madvoid/LEMS_PCB/README.txt

Eagle Files for LEMS PCB
Work in progress

The Mega Shield Schematic/Layout will be used as a reference in the future
