madvoid/LEMS_PCB/Shield.brd

## EAGLE design Shield.brd (2012-08-28)

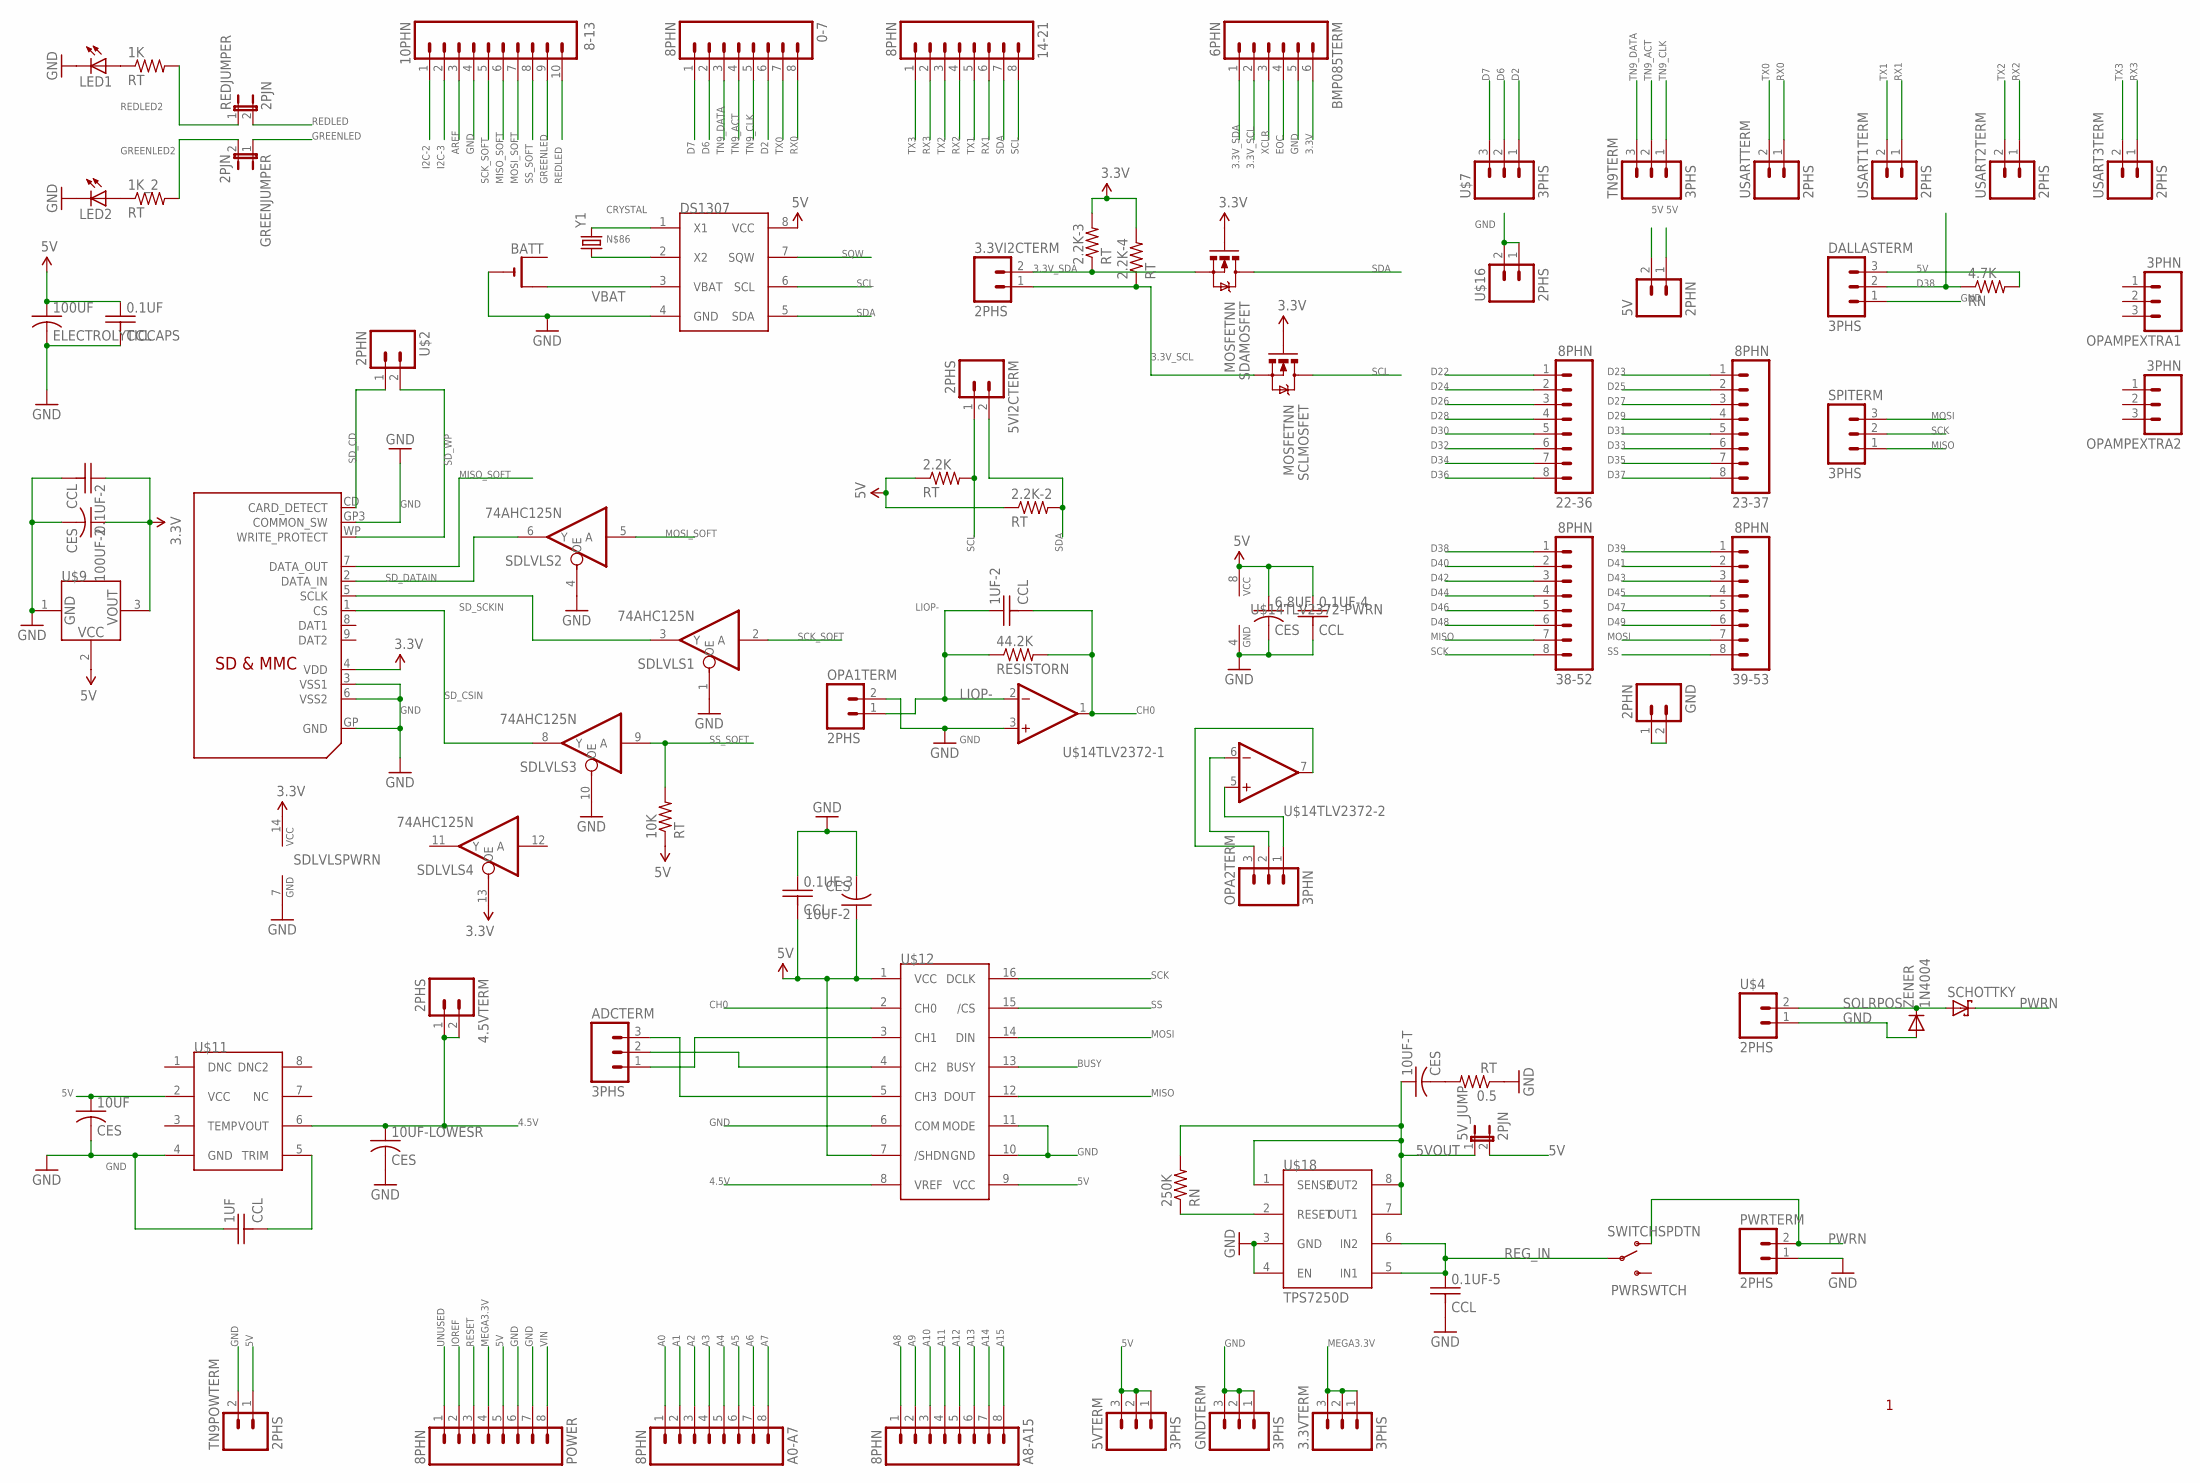
[picture p1: schematic Shield.sch]

Parts:
0-7, 14-21, 22-36, 23-37, 38-52, 39-53: 8PHN; 8PH
0.1UF, 0.1UF-2, 0.1UF-3, 0.1UF-4, 0.1UF-5, 1UF, 1UF-2: CCL; C025-025X050
0.5, 1K, 1K_2, 2.2K, 2.2K-2, 2.2K-3, 2.2K-4, 10K: RT; 0207/7
3.3VI2CTERM, 4.5VTERM, 5VI2CTERM: 2PHS; SCREWTERMINAL-3.5MM-2_LOCK
3.3VTERM, 5VTERM: 3PHS; SCREWTERMINAL-3.5MM-3_LOCK.007S
4.7K, 250K: RN; 0207/10
5V: 2PHN; 2PH
5V_JUMP: 2PJN; 2PH
6.8UF, 10UF, 10UF-2, 10UF-LOWESR, 10UF-T, 100UF-2: CES; E2,5-5
8-13: 10PHN; 10PH
44.2K: RESISTORN; 0207/10
100UF: ELECTROLYTICCAPS; E2,5-5
A0-A7, A8-A15: 8PHN; 8PH
ADCTERM: 3PHS; SCREWTERMINAL-3.5MM-3_LOCK.007S
BATT: CR1220THM; CR1220-THM
BMP085TERM: 6PHN; 6PH
DALLASTERM: 3PHS; SCREWTERMINAL-3.5MM-3_LOCK.007S
DS1307: DS1307P; DIL8
GND: 2PHN; 2PH
GNDTERM: 3PHS; SCREWTERMINAL-3.5MM-3_LOCK.007S
GREENJUMPER: 2PJN; 2PH
LED1, LED2: LED3MM
OPA1TERM: 2PHS; SCREWTERMINAL-3.5MM-2_LOCK
OPA2TERM: 3PHN; 3PH
OPAMPEXTRA1, OPAMPEXTRA2: 3PHN; 3PH
POWER: 8PHN; 8PH
PWRSWTCH: SWITCHSPDTN; SWITCH-SPDT
PWRTERM: 2PHS; SCREWTERMINAL-3.5MM-2_LOCK
REDJUMPER: 2PJN; 2PH
SCHOTTKY: SCHOTTKY-DIODEDO41; DO41-10
SCLMOSFET: MOSFETNN; TO-92INLINE
SDAMOSFET: MOSFETNN; TO-92INLINE
SDLVLS: 74AHC125N; DIL14
SPITERM: 3PHS; SCREWTERMINAL-3.5MM-3_LOCK.007S
TN9POWTERM: 2PHS; SCREWTERMINAL-3.5MM-2_LOCK
TN9TERM: 3PHS; SCREWTERMINAL-3.5MM-3_LOCK.007S
U$1: SDMMC06132; 06132
U$2: 2PHN; 2PH
U$4, U$16: 2PHS; SCREWTERMINAL-3.5MM-2_LOCK
U$7: 3PHS; SCREWTERMINAL-3.5MM-3_LOCK.007S
U$9: MCP1700-330T; TO-92INLINE
U$11: REF5045S; SOIC8
U$12: ADS7841P; DIL16
U$14: TLV2372P; DIL8
U$18: TPS7250D; DIL8
USART1TERM, USART2TERM, USART3TERM: 2PHS; SCREWTERMINAL-3.5MM-2_LOCK
USARTTERM: 2PHS; SCREWTERMINAL-3.5MM-2_LOCK
Y1: CRYSTALTC38H; TC38H
ZENER: 1N4004; DO41-10

Connections:
3.3V: 0.1UF-2.1, 2.2K-3.2, 2.2K-4.2, 100UF-2.+ (1), BMP085TERM.6, SCLMOSFET.2 (G), SDAMOSFET.2 (G), SDLVLS.13 (OE), SDLVLS.14 (VCC), U$1.4 (VDD), U$9.3 (VOUT)
3.3V_SCL: 2.2K-4.1, 3.3VI2CTERM.1, BMP085TERM.2, SCLMOSFET.1 (S)
3.3V_SDA: 2.2K-3.1, 3.3VI2CTERM.2, BMP085TERM.1, SDAMOSFET.1 (S)
4.5V: 4.5VTERM.1, 4.5VTERM.2, 10UF-LOWESR.+ (1), U$11.6 (VOUT), U$12.8 (VREF)
5V: 0.1UF.1, 0.1UF-3.2, 0.1UF-4.1, 2.2K.1, 2.2K-2.1, 4.7K.2, 5V.1, 5V.2, 5VTERM.1, 5VTERM.2, 5VTERM.3, 5V_JUMP.2, 6.8UF.+ (1), 10K.1, 10UF.+ (1), 10UF-2.+ (1), 100UF.+ (1), DALLASTERM.3, DS1307.8 (VCC), POWER.5, TN9POWTERM.1, U$9.2 (VCC), U$11.2 (VCC), U$12.1 (VCC), U$12.7 (/SHDN), U$12.9 (VCC), U$14.8 (VCC)
5VOUT: 5V_JUMP.1, 10UF-T.+ (1), 250K.2, U$18.1 (SENSE), U$18.7 (OUT1), U$18.8 (OUT2)
A0: A0-A7.1
A1: A0-A7.2
A2: A0-A7.3
A3: A0-A7.4
A4: A0-A7.5
A5: A0-A7.6
A6: A0-A7.7
A7: A0-A7.8
A8: A8-A15.1
A9: A8-A15.2
A10: A8-A15.3
A11: A8-A15.4
A12: A8-A15.5
A13: A8-A15.6
A14: A8-A15.7
A15: A8-A15.8
AREF: 8-13.3
BUSY: U$12.13 (BUSY)
CH0: 1UF-2.2, 44.2K.2, U$12.2 (CH0), U$14.1 (OUT)
CH1: ADCTERM.1, U$12.3 (CH1)
CH2: ADCTERM.2, U$12.4 (CH2)
CH3: ADCTERM.3, U$12.5 (CH3)
CRYSTAL: DS1307.1 (X1), Y1.2
D2: 0-7.6, U$7.1
D6: 0-7.2, U$7.2
D7: 0-7.1, U$7.3
D22: 22-36.1
D23: 23-37.1
D24: 22-36.2
D25: 23-37.2
D26: 22-36.3
D27: 23-37.3
D28: 22-36.4
D29: 23-37.4
D30: 22-36.5
D31: 23-37.5
D32: 22-36.6
D33: 23-37.6
D34: 22-36.7
D35: 23-37.7
D36: 22-36.8
D37: 23-37.8
D38: 4.7K.1, 38-52.1, DALLASTERM.2
D39: 39-53.1
D40: 38-52.2
D41: 39-53.2
D42: 38-52.3
D43: 39-53.3
D44: 38-52.4
D45: 39-53.4
D46: 38-52.5
D47: 39-53.5
D48: 38-52.6
D49: 39-53.6
EOC: BMP085TERM.4
GND: 0.1UF.2, 0.1UF-2.2, 0.1UF-3.1, 0.1UF-4.2, 0.1UF-5.2, 0.5.1, 1UF.1, 6.8UF.- (2), 8-13.4, 10UF.- (2), 10UF-2.- (2), 10UF-LOWESR.- (2), 100UF.- (2), 100UF-2.- (2), BATT.-, BMP085TERM.5, DALLASTERM.1, DS1307.4 (GND), GNDTERM.1, GNDTERM.2, GNDTERM.3, LED1.K (C), LED2.K (C), OPA1TERM.2, POWER.6, POWER.7, PWRTERM.1, SDLVLS.1 (OE), SDLVLS.4 (OE), SDLVLS.7 (GND), SDLVLS.10 (OE), TN9POWTERM.2, U$1.3 (VSS1), U$1.6 (VSS2), U$1.GP (GND), U$1.GP3 (COMMON_SW), U$4.1, U$9.1 (GND), U$11.4 (GND), U$12.6 (COM), U$12.10 (GND), U$12.11 (MODE), U$14.3 (+IN), U$14.4 (GND), U$16.1, U$16.2, U$18.3 (GND), U$18.4 (EN), ZENER.A
GREENLED: 8-13.9, GREENJUMPER.1
GREENLED2: 1K_2.2, GREENJUMPER.2
I2C-2: 8-13.1
I2C-3: 8-13.2
IOREF: POWER.2
LIOP-: 1UF-2.1, 44.2K.1, OPA1TERM.1, U$14.2 (-IN)
MEGA3.3V: 3.3VTERM.1, 3.3VTERM.2, 3.3VTERM.3, POWER.4
MISO: 38-52.7, SPITERM.1, U$12.12 (DOUT)
MISO_SOFT: 8-13.6, U$1.7 (DATA_OUT)
MOSI: 39-53.7, SPITERM.3, U$12.14 (DIN)
MOSI_SOFT: 8-13.7, SDLVLS.5 (A)
unnamed: 1UF.2, U$11.5 (TRIM)
unnamed: OPA2TERM.1, U$14.5 (+IN)
unnamed: OPA2TERM.2, U$14.6 (-IN)
unnamed: OPA2TERM.3, U$14.7 (OUT)
unnamed: GND.1, GND.2
unnamed: 250K.1, U$18.2 (RESET)
unnamed: 0.5.2, 10UF-T.- (2)
unnamed: 1K.1, LED1.A
unnamed: 1K_2.1, LED2.A
unnamed: DS1307.2 (X2), Y1.1
PWRN: PWRSWTCH.1 (O), PWRTERM.2, SCHOTTKY.C
REDLED: 8-13.10, REDJUMPER.2
REDLED2: 1K.2, REDJUMPER.1
REG_IN: 0.1UF-5.1, PWRSWTCH.2, U$18.5 (IN1), U$18.6 (IN2)
RESET: POWER.3
RX0: 0-7.8, USARTTERM.1
RX1: 14-21.6, USART1TERM.1
RX2: 14-21.4, USART2TERM.1
RX3: 14-21.2, USART3TERM.1
SCK: 38-52.8, SPITERM.2, U$12.16 (DCLK)
SCK_SOFT: 8-13.5, SDLVLS.2 (A)
SCL: 2.2K.2, 5VI2CTERM.1, 14-21.8, DS1307.6 (SCL), SCLMOSFET.3 (D)
SDA: 2.2K-2.2, 5VI2CTERM.2, 14-21.7, DS1307.5 (SDA), SDAMOSFET.3 (D)
SD_CD: U$1.CD (CARD_DETECT), U$2.1
SD_CSIN: SDLVLS.8 (Y), U$1.1 (CS)
SD_DATAIN: SDLVLS.6 (Y), U$1.2 (DATA_IN)
SD_SCKIN: SDLVLS.3 (Y), U$1.5 (SCLK)
SD_WP: U$1.WP (WRITE_PROTECT), U$2.2
SOLRPOS: SCHOTTKY.A, U$4.2, ZENER.C
SQW: DS1307.7 (SQW)
SS: 39-53.8, U$12.15 (/CS)
SS_SOFT: 8-13.8, 10K.2, SDLVLS.9 (A)
TN9_ACT: 0-7.4, TN9TERM.2
TN9_CLK: 0-7.5, TN9TERM.1
TN9_DATA: 0-7.3, TN9TERM.3
TX0: 0-7.7, USARTTERM.2
TX1: 14-21.5, USART1TERM.2
TX2: 14-21.3, USART2TERM.2
TX3: 14-21.1, USART3TERM.2
UNUSED: POWER.1
VBAT: BATT.+2 (+1), DS1307.3 (VBAT)
VIN: POWER.8
XCLR: BMP085TERM.3

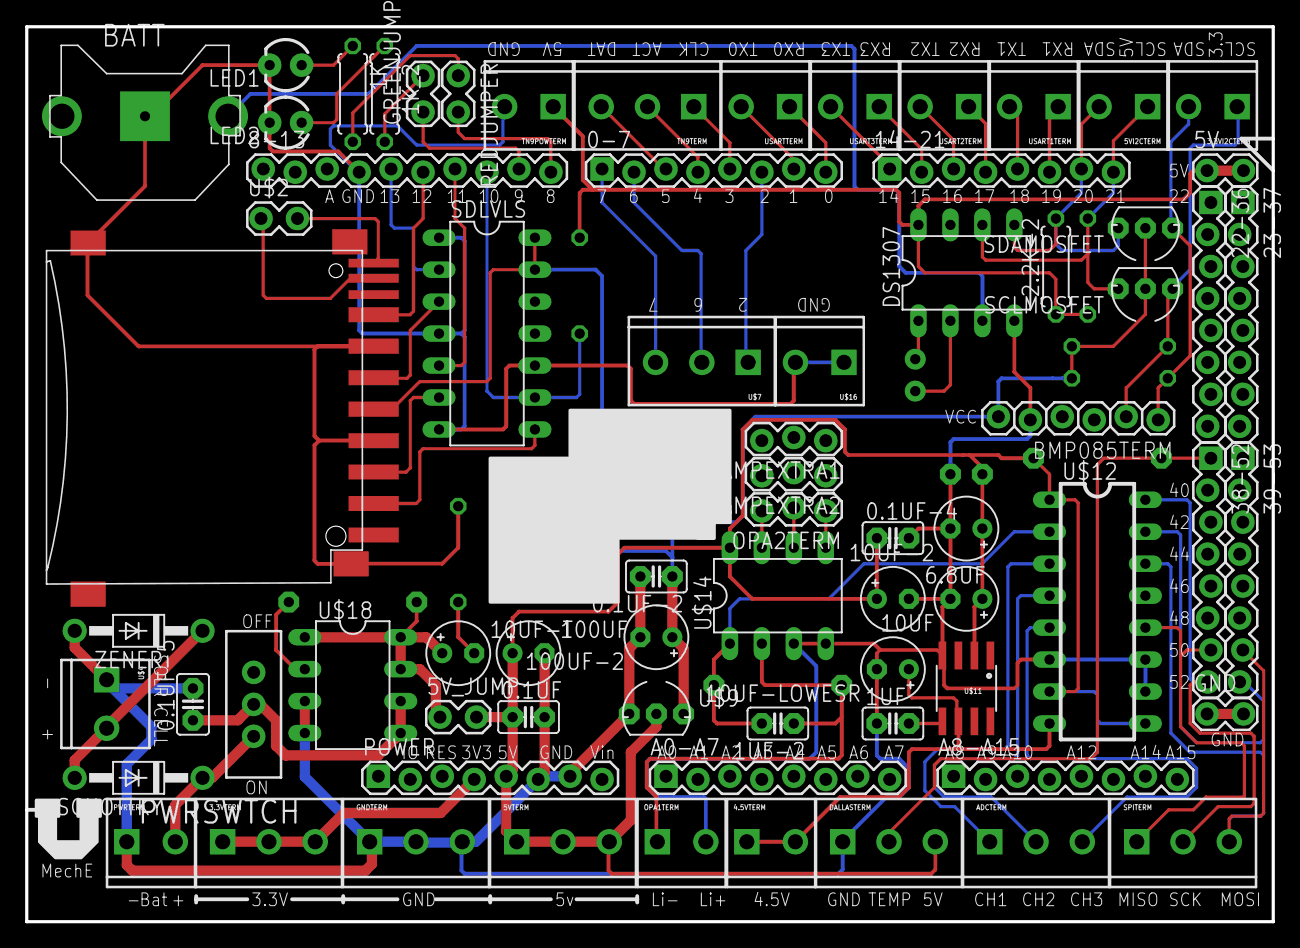
[picture p2: board Shield.brd from above]

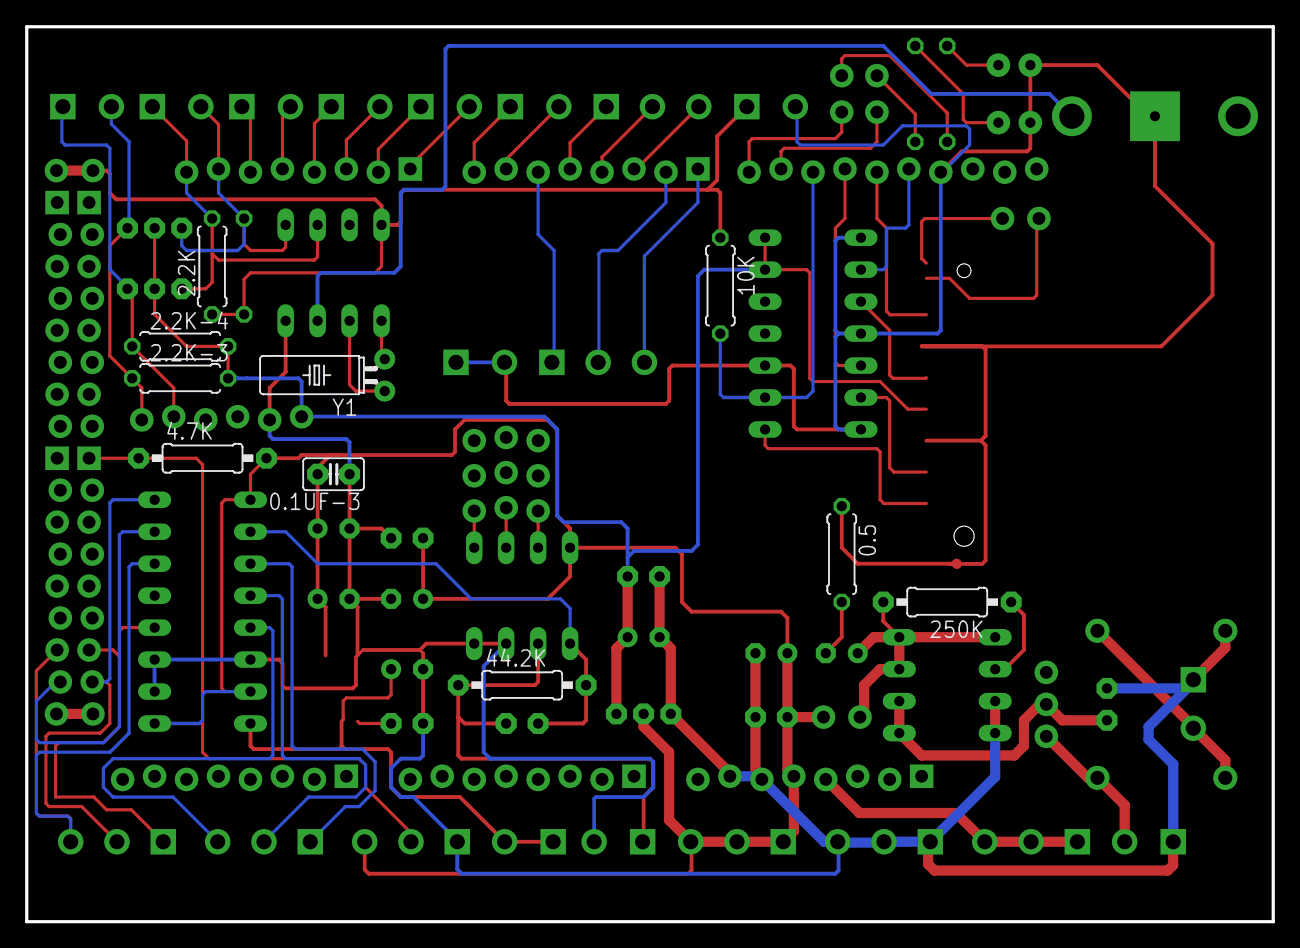
[picture p3: board Shield.brd from below]

Board: 2 copper layers, 99.1 x 71.1 mm, 82 parts (10 on the bottom side), 62 nets.
