madvoid/LEMS_PCB/(commit log)

2012-05-08 Added Mega Shield reference and various components
    [Mega_Shield-v13.brd, Mega_Shield-v13.sch, Shield.sch]
2012-05-16 Added SD Card Circuit
    [Shield.sch]
2012-05-16 Added names and various details
    [Shield.sch]
2012-05-17 Added 4.5V Reference
    [Shield.sch]
2012-05-17 Added ADS7841
    [Shield.sch]
2012-05-18 First Complete Schematic
    [Shield.sch]
2012-05-18 Added board
    [Shield.brd, Shield.sch]
2012-05-18 All components on board
    [Shield.brd, Shield.sch]
2012-05-22 Started Routing
    [Shield.brd, Shield.sch]
2012-05-22 Improved Routing
    [Shield.brd, Shield.sch]
2012-05-22 Continued routing
    [Shield.brd, Shield.sch]
2012-05-23 Almost complete routing
    [Shield.brd, Shield.sch]
2012-05-23 First completed routing
    [Shield.brd, Shield.sch]
2012-05-23 Final before GERBER files
    [Shield.brd]
2012-05-23 Added Gerber Files
    [Shield.brd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]
2012-06-04 Added Soldering Order List
    [Shield.sch]
2012-06-13 Beginning Board Revision 2
    [Shield.brd, Shield.sch]
2012-06-13 Still need to finalize power components
    [Shield.brd, Shield.sch]
2012-06-14 Complete Prototype #2
    [Shield.brd, Shield.sch]
2012-06-20 Started Revision 3
    [Shield.brd, Shield.sch]
2012-06-21 About to add charging circuit
    [Shield.sch]
2012-06-21 Added everything but power, charging, and various silkscreen
    [Shield.brd]
2012-06-22 Added charging circuit to schematic
    [Shield.brd, Shield.sch]
2012-06-22 Changed charging circuit, finished routing
    [Shield.brd, Shield.sch]
2012-06-22 Ready to create gerber files for Mk2
    [Shield.brd]
2012-06-26 Added middle screw terminals
    [Shield.brd, Shield.sch]
2012-06-29 Added marking area
    [Shield.GBL, Shield.GBS, Shield.GTL, Shield.GTO, Shield.GTS]
2012-07-06 Minor Spacing Changes
    [Shield.brd, Shield.sch]
2012-08-28 Ready for Quantity Manufacturing
    [Shield.brd, Shield.sch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]
